ameyarya/peephole-door-cam/hardware/enclosure/stl/enclosure_lid.stl

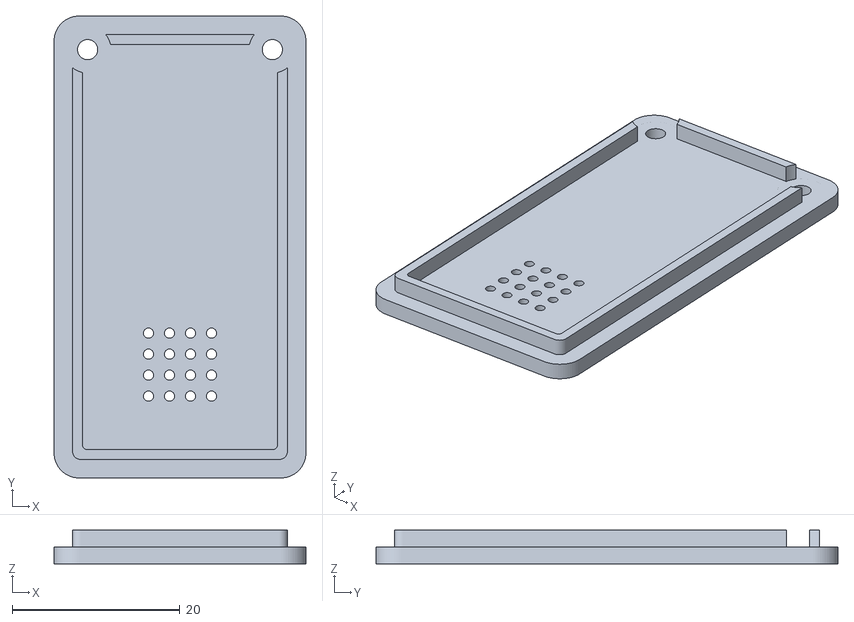
[picture p2: CAD file, 2026-10-30]
hardware/enclosure/stl/enclosure_lid.stl
30.0 x 55.0 x 3.99
