ameyarya/peephole-door-cam/hardware/peephole-mount/stl/housing_v2.stl

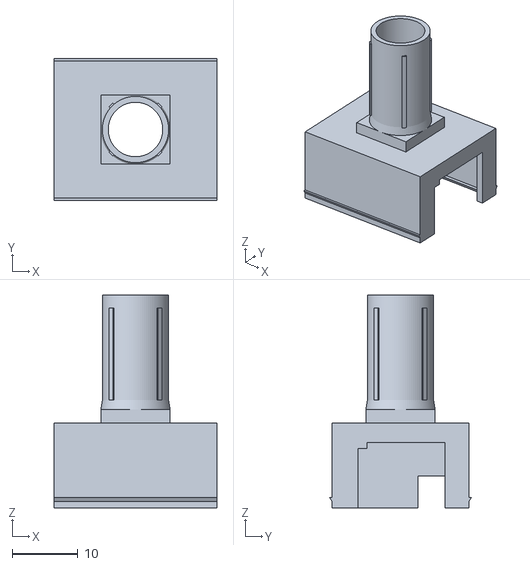
[picture p3: CAD file, 2026-11-03]
hardware/peephole-mount/stl/housing_v2.stl
24.8 x 21.7 x 32.5
