ameyarya/peephole-door-cam/hardware/peephole-sleeve/stl/sleeve_half.stl

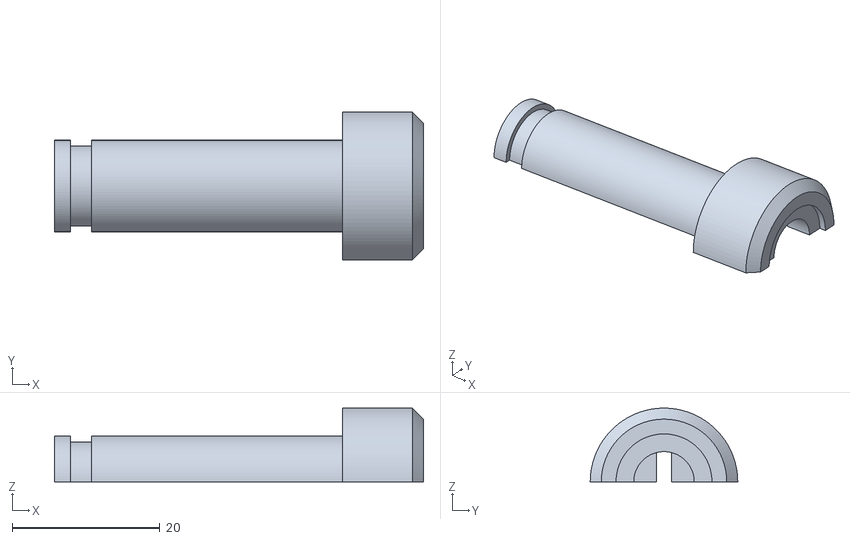
[picture p4: CAD file, 2026-10-30]
hardware/peephole-sleeve/stl/sleeve_half.stl
50.0 x 20.0 x 10.0
