ameyarya/peephole-door-cam/hardware/enclosure/stl/enclosure_body.stl

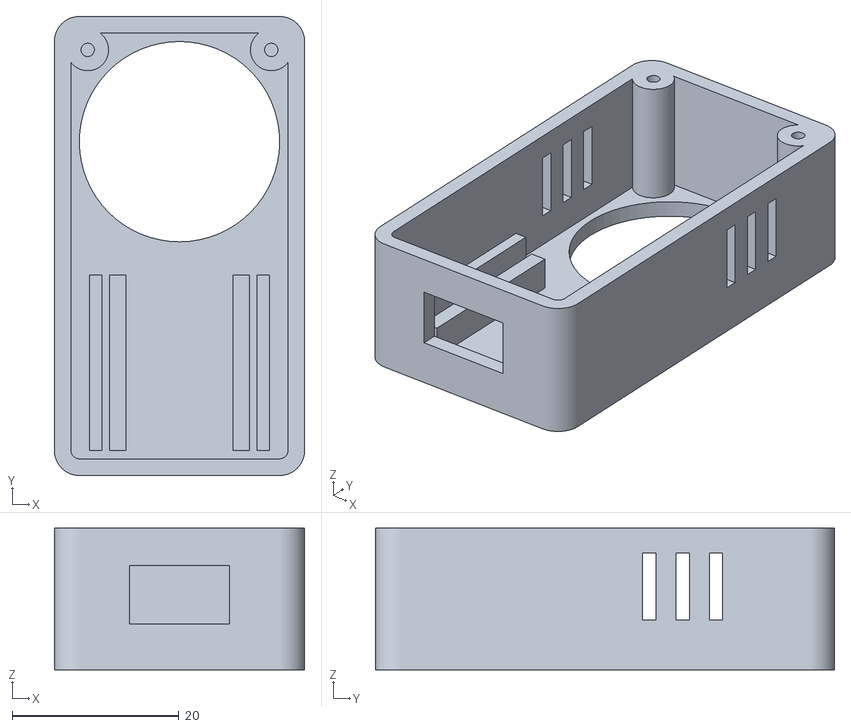
[picture p5: CAD file, 2026-10-30]
hardware/enclosure/stl/enclosure_body.stl
30.0 x 55.0 x 17.0
