ameyarya/peephole-door-cam/hardware/peephole-mount/stl/lid_v2.stl

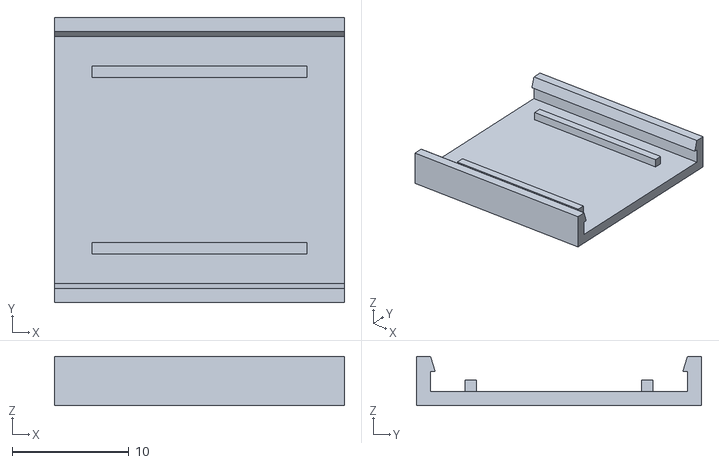
[picture p6: CAD file, 2026-11-03]
hardware/peephole-mount/stl/lid_v2.stl
24.8 x 24.4 x 4.20
