ameyarya/peephole-door-cam/hardware/peephole-sleeve/stl/clip.stl

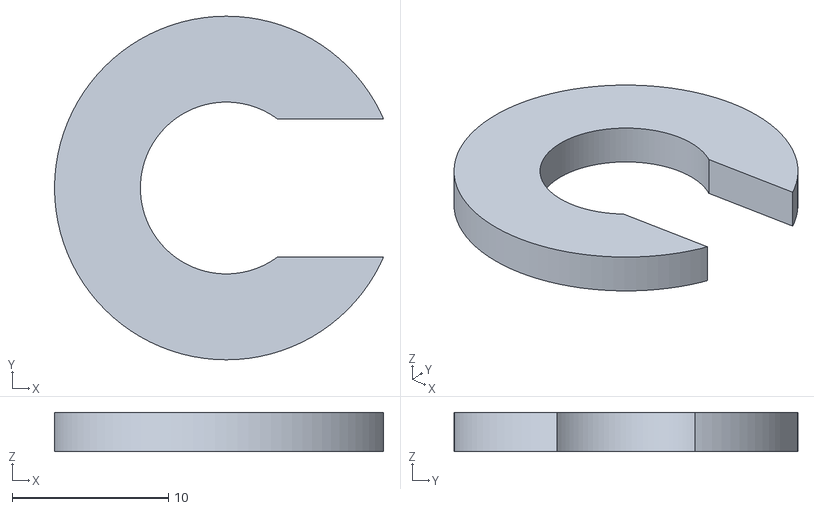
[picture p7: CAD file, 2026-10-30]
hardware/peephole-sleeve/stl/clip.stl
21.1 x 22.0 x 2.50
