ameyarya/peephole-door-cam/hardware/peephole-mount/stl/housing_v1.stl

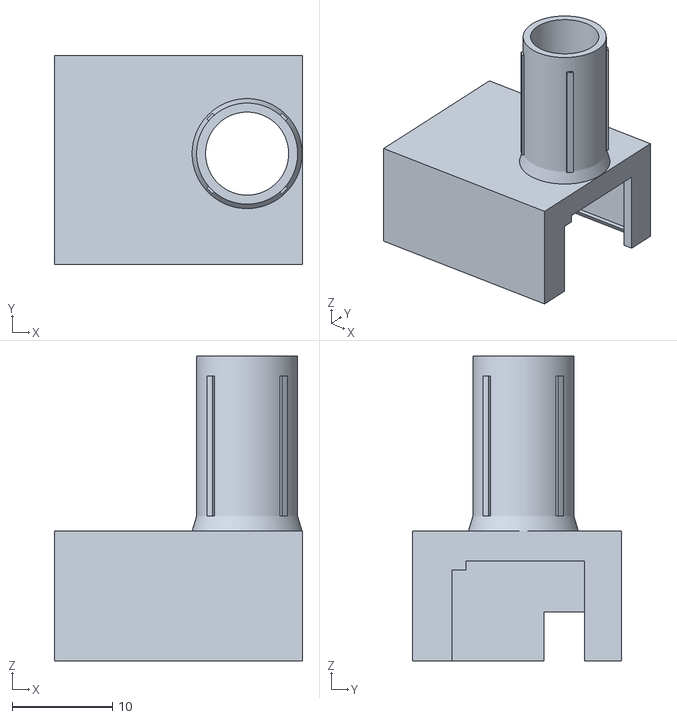
[picture p8: CAD file, 2026-11-03, an earlier design]
hardware/peephole-mount/stl/housing_v1.stl
24.8 x 20.9 x 30.5
