ameyarya/peephole-door-cam/firmware/src/main.cpp

// Door camera firmware for the XIAO ESP32S3 Sense and AI-Thinker ESP32-CAM.
//
//   http://door-cam.local/         test page
//   http://door-cam.local/capture  one JPEG
//   http://door-cam.local/status   JSON health info
//   http://door-cam.local/control?framesize=vga&quality=12&vflip=1&hmirror=0
//   http://door-cam.local:81/stream  MJPEG, up to 4 viewers at once
//   http://door-cam.local:82/audio?token=...  live 16 kHz mono PCM, up to 2 listeners
//   POST http://door-cam.local/ota  firmware image, with an X-Token header (see ota.sh)
//   POST http://door-cam.local/doorbell-url  body: the URL to POST to on a ring
//   POST http://door-cam.local/ring          acts as if the bell rang
//
// The camera and mic run all the time. With CHIME_DETECT the board listens for the
// doorbell itself, and only streams audio to someone holding the token.
//
// Only updates and the mic need the token in secrets.h. Everything else has no
// authentication, so keep this on a trusted network and never port-forward it.

#include <Arduino.h>
#include <ESPmDNS.h>
#include <HTTPClient.h>
#include <Preferences.h>
#include <WiFi.h>
#include <WiFiManager.h>

#include "esp_camera.h"
#include "esp_heap_caps.h"
#include "freertos/semphr.h"
#include "esp_http_server.h"

#if defined(AUDIO_STREAM) || defined(CHIME_DETECT)
#include "driver/i2s_pdm.h"
#endif

#ifdef BOARD_XIAO_S3_SENSE
#include <Update.h>
#include "esp_ota_ops.h"
#endif

#if __has_include("secrets.h")
#include "secrets.h"
#else
#define DOORCAM_TOKEN ""
#endif

static bool tokenMatches(const char *given) {
  return DOORCAM_TOKEN[0] != 0 && strcmp(given, DOORCAM_TOKEN) == 0;
}

static const char *HOSTNAME = "door-cam";
static const char *SETUP_AP = "door-cam-setup";

static camera_config_t cameraConfig() {
  camera_config_t c = {};
#ifdef BOARD_XIAO_S3_SENSE
  c.pin_pwdn = -1;
  c.pin_reset = -1;
  c.pin_xclk = 10;
  c.pin_sccb_sda = 40;
  c.pin_sccb_scl = 39;
  c.pin_d7 = 48;
  c.pin_d6 = 11;
  c.pin_d5 = 12;
  c.pin_d4 = 14;
  c.pin_d3 = 16;
  c.pin_d2 = 18;
  c.pin_d1 = 17;
  c.pin_d0 = 15;
  c.pin_vsync = 38;
  c.pin_href = 47;
  c.pin_pclk = 13;
#else  // AI-Thinker ESP32-CAM
  c.pin_pwdn = 32;
  c.pin_reset = -1;
  c.pin_xclk = 0;
  c.pin_sccb_sda = 26;
  c.pin_sccb_scl = 27;
  c.pin_d7 = 35;
  c.pin_d6 = 34;
  c.pin_d5 = 39;
  c.pin_d4 = 36;
  c.pin_d3 = 21;
  c.pin_d2 = 19;
  c.pin_d1 = 18;
  c.pin_d0 = 5;
  c.pin_vsync = 25;
  c.pin_href = 23;
  c.pin_pclk = 22;
#endif
  c.xclk_freq_hz = 10000000;  // half the usual 20 MHz: fewer frames from the sensor, and much less heat
  c.ledc_timer = LEDC_TIMER_0;
  c.ledc_channel = LEDC_CHANNEL_0;
  c.pixel_format = PIXFORMAT_JPEG;
  c.frame_size = FRAMESIZE_VGA;
  c.jpeg_quality = 12;
  c.fb_count = 2;
  c.fb_location = CAMERA_FB_IN_PSRAM;
  c.grab_mode = CAMERA_GRAB_LATEST;  // live view: drop stale frames
  return c;
}

static const int MAX_STREAM_CLIENTS = 4;
static const int MAX_CAPTURE_FAILURES = 5;
static const uint32_t FRAME_MS = 100;        // 10 frames a second is plenty for a door, and runs cooler
static const uint32_t CAMERA_IDLE_MS = 10000;  // the sensor sleeps this long after the last viewer leaves
static const int WAKE_SKIP_FRAMES = 4;       // frames to drop after waking, while exposure settles

static volatile uint32_t framesSent = 0;
static volatile int streamClients = 0;
static volatile uint32_t rings = 0;
static volatile bool updating = false;  // flash writes and camera DMA don't mix

#ifdef CHIME_DETECT
#include "chime_detector.h"
static ChimeDetector detector;
#endif

// One task grabs each camera frame and shares it with every viewer through
// reference-counted copies in PSRAM, so a slow or dead connection can't hold up
// the others.
struct SharedFrame {
  uint8_t *buf;
  size_t len;
  uint32_t seq;
  int refs;
};

static SemaphoreHandle_t frameLock;
static SharedFrame *latestFrame = nullptr;
static volatile int viewers = 0;
static volatile bool cameraAsleep = false;

static void releaseLocked(SharedFrame *frame) {
  if (frame && --frame->refs == 0) {
    heap_caps_free(frame->buf);
    heap_caps_free(frame);
  }
}

static void frameRelease(SharedFrame *frame) {
  xSemaphoreTake(frameLock, portMAX_DELAY);
  releaseLocked(frame);
  xSemaphoreGive(frameLock);
}

static uint32_t latestSeq() {
  xSemaphoreTake(frameLock, portMAX_DELAY);
  uint32_t seq = latestFrame ? latestFrame->seq : 0;
  xSemaphoreGive(frameLock);
  return seq;
}

// Waits for a frame newer than afterSeq. Returns nullptr on timeout.
static SharedFrame *frameAcquire(uint32_t afterSeq, TickType_t timeout) {
  TickType_t start = xTaskGetTickCount();
  for (;;) {
    xSemaphoreTake(frameLock, portMAX_DELAY);
    SharedFrame *frame = latestFrame;
    if (frame && frame->seq > afterSeq) {
      frame->refs++;
      xSemaphoreGive(frameLock);
      return frame;
    }
    xSemaphoreGive(frameLock);
    if (xTaskGetTickCount() - start >= timeout) return nullptr;
    vTaskDelay(pdMS_TO_TICKS(5));
  }
}

static void viewerAdd() {
  xSemaphoreTake(frameLock, portMAX_DELAY);
  viewers = viewers + 1;
  xSemaphoreGive(frameLock);
}

// Claims a stream slot. False when all are taken.
static bool streamSlotClaim() {
  xSemaphoreTake(frameLock, portMAX_DELAY);
  bool ok = streamClients < MAX_STREAM_CLIENTS;
  if (ok) streamClients = streamClients + 1;
  xSemaphoreGive(frameLock);
  return ok;
}

static void streamSlotRelease() {
  xSemaphoreTake(frameLock, portMAX_DELAY);
  streamClients = streamClients - 1;
  xSemaphoreGive(frameLock);
}

static void viewerRemove() {
  xSemaphoreTake(frameLock, portMAX_DELAY);
  viewers = viewers - 1;
  xSemaphoreGive(frameLock);
}

// The OV3660 has a software standby. The ESP32-CAM's OV2640 just keeps running.
static bool sensorSleep(bool sleep) {
  sensor_t *s = esp_camera_sensor_get();
  if (!s || s->id.PID != OV3660_PID) return false;
  s->set_reg(s, 0x3008, 0x40, sleep ? 0x40 : 0x00);  // SYSTEM CTROL0, bit 6: power down
  return true;
}

// Grabs frames only while someone is watching, at most one every FRAME_MS. With no
// viewers for CAMERA_IDLE_MS the sensor goes to standby, which keeps the board cool.
static void captureTask(void *) {
  uint32_t seq = 0;
  int failures = 0, skip = 0;
  uint32_t lastViewer = millis(), lastGrab = 0;
  for (;;) {
    if (viewers <= 0 || updating) {
      if (!cameraAsleep && viewers <= 0 && millis() - lastViewer > CAMERA_IDLE_MS && sensorSleep(true)) {
        cameraAsleep = true;
        Serial.println("No viewers: camera asleep");
      }
      vTaskDelay(pdMS_TO_TICKS(20));
      continue;
    }
    lastViewer = millis();
    if (cameraAsleep) {
      sensorSleep(false);
      cameraAsleep = false;
      skip = WAKE_SKIP_FRAMES;
      failures = 0;
    }
    uint32_t since = millis() - lastGrab;
    if (since < FRAME_MS) vTaskDelay(pdMS_TO_TICKS(FRAME_MS - since));
    lastGrab = millis();
    camera_fb_t *fb = esp_camera_fb_get();
    if (!fb) {
      if (++failures >= MAX_CAPTURE_FAILURES) {
        Serial.println("Camera keeps failing. Restarting.");
        ESP.restart();
      }
      vTaskDelay(pdMS_TO_TICKS(10));
      continue;
    }
    failures = 0;
    if (skip > 0) {  // stale or still settling after standby
      skip--;
      esp_camera_fb_return(fb);
      continue;
    }
    SharedFrame *frame = (SharedFrame *)heap_caps_malloc(sizeof(SharedFrame), MALLOC_CAP_SPIRAM);
    uint8_t *buf = (uint8_t *)heap_caps_malloc(fb->len, MALLOC_CAP_SPIRAM);
    if (!frame || !buf) {
      heap_caps_free(frame);
      heap_caps_free(buf);
      esp_camera_fb_return(fb);
      Serial.println("Out of PSRAM for a frame copy");
      vTaskDelay(pdMS_TO_TICKS(50));
      continue;
    }
    memcpy(buf, fb->buf, fb->len);
    *frame = {buf, fb->len, ++seq, 1};
    esp_camera_fb_return(fb);

    xSemaphoreTake(frameLock, portMAX_DELAY);
    SharedFrame *old = latestFrame;
    latestFrame = frame;
    releaseLocked(old);
    xSemaphoreGive(frameLock);
  }
}

static const char PAGE[] = R"html(<!doctype html>
<meta name=viewport content="width=device-width,initial-scale=1">
<title>Door cam</title>
<style>body{font:16px system-ui;margin:16px;background:#111;color:#eee}img{max-width:100%}a{color:#8cf}</style>
<h1>Door cam</h1>
<img id=s alt="live stream">
<p><a href=/capture>Snapshot</a> · <a href=/status>Status</a></p>
<script>s.src=location.protocol+'//'+location.hostname+':81/stream'</script>
)html";

static esp_err_t pageHandler(httpd_req_t *req) {
  httpd_resp_set_type(req, "text/html");
  return httpd_resp_send(req, PAGE, HTTPD_RESP_USE_STRLEN);
}

static esp_err_t captureHandler(httpd_req_t *req) {
  viewerAdd();
  SharedFrame *frame = frameAcquire(latestSeq(), pdMS_TO_TICKS(3000));
  viewerRemove();
  if (!frame) {
    httpd_resp_send_500(req);
    return ESP_FAIL;
  }
  httpd_resp_set_type(req, "image/jpeg");
  httpd_resp_set_hdr(req, "Cache-Control", "no-store");
  esp_err_t res = httpd_resp_send(req, (const char *)frame->buf, frame->len);
  frameRelease(frame);
  return res;
}

static const char *runningPartition() {
#ifdef BOARD_XIAO_S3_SENSE
  return esp_ota_get_running_partition()->label;
#else
  return "";
#endif
}

static esp_err_t statusHandler(httpd_req_t *req) {
  sensor_t *s = esp_camera_sensor_get();
  char json[640];
  snprintf(json, sizeof(json),
           "{\"ip\":\"%s\",\"rssi\":%d,\"uptime_s\":%lu,\"free_heap\":%u,"
           "\"free_psram\":%u,\"frames_sent\":%lu,\"stream_clients\":%d,\"rings\":%lu,"
           "\"framesize\":%d,\"quality\":%d,\"running\":\"%s\",\"built\":\"%s\","
           "\"camera_asleep\":%s,\"chip_c\":%.0f}",
           WiFi.localIP().toString().c_str(), WiFi.RSSI(),
           (unsigned long)(millis() / 1000), (unsigned)ESP.getFreeHeap(),
           (unsigned)ESP.getFreePsram(), (unsigned long)framesSent,
           streamClients, (unsigned long)rings, s ? s->status.framesize : -1,
           s ? s->status.quality : -1, runningPartition(), __DATE__ " " __TIME__,
           cameraAsleep ? "true" : "false", temperatureRead());
#ifdef CHIME_DETECT
  // Numbers about the last bell-like sound. No audio.
  ChimeDetector::Strike st;
  if (detector.lastStrike(&st)) {
    size_t used = strlen(json) - 1;
    snprintf(json + used, sizeof(json) - used,
             ",\"last_strike\":{\"age_s\":%.0f,\"level_db\":%.0f,\"purity\":%.2f,\"attack_db\":%.0f,"
             "\"fade_db_s\":%.1f,\"wobble_db\":%.2f,\"overtone_db\":%.0f,\"early_drop_db\":%.1f,\"passed\":%s}}",
             st.ageSeconds, st.level, st.purity, st.attack, st.fade, st.wobble, st.overtone, st.earlyDrop,
             st.passed ? "true" : "false");
  }
#endif
  httpd_resp_set_type(req, "application/json");
  return httpd_resp_send(req, json, HTTPD_RESP_USE_STRLEN);
}

static int frameSizeFromName(const char *name) {
  if (!strcmp(name, "qvga")) return FRAMESIZE_QVGA;
  if (!strcmp(name, "vga")) return FRAMESIZE_VGA;
  if (!strcmp(name, "svga")) return FRAMESIZE_SVGA;
  if (!strcmp(name, "xga")) return FRAMESIZE_XGA;
  if (!strcmp(name, "hd")) return FRAMESIZE_HD;
  return -1;
}

static esp_err_t controlHandler(httpd_req_t *req) {
  char query[96], value[16];
  sensor_t *s = esp_camera_sensor_get();
  if (!s || httpd_req_get_url_query_str(req, query, sizeof(query)) != ESP_OK) {
    httpd_resp_send_err(req, HTTPD_400_BAD_REQUEST, "missing settings");
    return ESP_FAIL;
  }
  if (httpd_query_key_value(query, "framesize", value, sizeof(value)) == ESP_OK) {
    int size = frameSizeFromName(value);
    if (size < 0) {
      httpd_resp_send_err(req, HTTPD_400_BAD_REQUEST, "unknown framesize");
      return ESP_FAIL;
    }
    s->set_framesize(s, (framesize_t)size);
  }
  if (httpd_query_key_value(query, "quality", value, sizeof(value)) == ESP_OK)
    s->set_quality(s, constrain(atoi(value), 4, 63));
  if (httpd_query_key_value(query, "vflip", value, sizeof(value)) == ESP_OK)
    s->set_vflip(s, atoi(value) ? 1 : 0);
  if (httpd_query_key_value(query, "hmirror", value, sizeof(value)) == ESP_OK)
    s->set_hmirror(s, atoi(value) ? 1 : 0);
  return httpd_resp_sendstr(req, "ok");
}

#define BOUNDARY "doorcamframe"

// Each viewer gets its own task, so several can watch at once.
static void streamClientTask(void *arg) {
  httpd_req_t *req = (httpd_req_t *)arg;
  httpd_resp_set_type(req, "multipart/x-mixed-replace;boundary=" BOUNDARY);
  httpd_resp_set_hdr(req, "Access-Control-Allow-Origin", "*");
  viewerAdd();

  char header[64];
  uint32_t lastSeq = latestSeq();
  esp_err_t res = ESP_OK;
  while (res == ESP_OK) {
    SharedFrame *frame = frameAcquire(lastSeq, pdMS_TO_TICKS(3000));
    if (!frame) {
      Serial.println("No camera frame for 3s, closing a viewer");
      break;
    }
    lastSeq = frame->seq;
    int n = snprintf(header, sizeof(header),
                     "\r\n--" BOUNDARY "\r\nContent-Type: image/jpeg\r\n"
                     "Content-Length: %u\r\n\r\n",
                     (unsigned)frame->len);
    res = httpd_resp_send_chunk(req, header, n);
    if (res == ESP_OK)
      res = httpd_resp_send_chunk(req, (const char *)frame->buf, frame->len);
    frameRelease(frame);
    if (res == ESP_OK) framesSent = framesSent + 1;
  }

  viewerRemove();
  streamSlotRelease();
  httpd_req_async_handler_complete(req);
  vTaskDelete(nullptr);
}

static esp_err_t streamHandler(httpd_req_t *req) {
  if (!streamSlotClaim()) {
    httpd_resp_set_status(req, "503 Service Unavailable");
    return httpd_resp_sendstr(req, "too many viewers\n");
  }
  httpd_req_t *asyncReq = nullptr;
  esp_err_t err = httpd_req_async_handler_begin(req, &asyncReq);
  if (err == ESP_OK && xTaskCreate(streamClientTask, "stream_client", 4096, asyncReq, 5, nullptr) != pdPASS) {
    httpd_req_async_handler_complete(asyncReq);
    err = ESP_ERR_NO_MEM;
  }
  if (err != ESP_OK) streamSlotRelease();
  return err;
}

static Preferences prefs;
static volatile bool ringPending = false;

static esp_err_t ringHandler(httpd_req_t *req) {
  ringPending = true;
  return httpd_resp_sendstr(req, "ok");
}

static esp_err_t doorbellUrlHandler(httpd_req_t *req) {
  char url[240];
  if (req->content_len >= sizeof(url)) {
    httpd_resp_send_err(req, HTTPD_400_BAD_REQUEST, "too long");
    return ESP_FAIL;
  }
  int got = httpd_req_recv(req, url, req->content_len);
  if (got < 0 || (size_t)got != req->content_len) {
    httpd_resp_send_err(req, HTTPD_400_BAD_REQUEST, "bad body");
    return ESP_FAIL;
  }
  url[got] = 0;
  prefs.putString("doorbell_url", url);
  return httpd_resp_sendstr(req, "ok");
}

// Runs outside the audio task, so a slow TV can't make it miss samples.
static void sendRing() {
  rings = rings + 1;
  String url = prefs.getString("doorbell_url", "");
  if (url.isEmpty()) {
    Serial.println("Ring, but no doorbell URL is set");
    return;
  }
  HTTPClient http;
  http.setConnectTimeout(3000);
  http.setTimeout(5000);
  if (!http.begin(url)) {
    Serial.println("Ring: bad doorbell URL");
    return;
  }
  Serial.printf("Ring sent, answer %d\n", http.POST(""));  // never logs the URL: it holds a secret
  http.end();
}

#if defined(AUDIO_STREAM) || defined(CHIME_DETECT)
static i2s_chan_handle_t micChannel = nullptr;

static bool startMic() {
  i2s_chan_config_t chan = I2S_CHANNEL_DEFAULT_CONFIG(I2S_NUM_0, I2S_ROLE_MASTER);
  if (i2s_new_channel(&chan, nullptr, &micChannel) != ESP_OK) return false;
  i2s_pdm_rx_config_t pdm = {};
  pdm.clk_cfg = I2S_PDM_RX_CLK_DEFAULT_CONFIG(16000);
  pdm.slot_cfg = I2S_PDM_RX_SLOT_DEFAULT_CONFIG(I2S_DATA_BIT_WIDTH_16BIT, I2S_SLOT_MODE_MONO);
  pdm.gpio_cfg.clk = GPIO_NUM_42;
  pdm.gpio_cfg.din = GPIO_NUM_41;
  return i2s_channel_init_pdm_rx_mode(micChannel, &pdm) == ESP_OK &&
         i2s_channel_enable(micChannel) == ESP_OK;
}

#endif

#ifdef AUDIO_STREAM
// The last second of audio, for listeners. One writer: micTask.
static const uint32_t AUDIO_RING = 16000;
static const int MAX_AUDIO_CLIENTS = 2;
static int16_t *audioRing = nullptr;
static volatile uint32_t audioWritten = 0;
static volatile int audioClients = 0;

static void audioClientTask(void *arg) {
  httpd_req_t *req = (httpd_req_t *)arg;
  httpd_resp_set_type(req, "audio/L16;rate=16000;channels=1");
  uint32_t at = audioWritten;
  esp_err_t res = ESP_OK;
  while (res == ESP_OK) {
    uint32_t written = audioWritten;
    if (written == at) {
      vTaskDelay(pdMS_TO_TICKS(10));
      continue;
    }
    if (written - at > AUDIO_RING) at = written - AUDIO_RING / 2;  // too slow: skip ahead
    uint32_t offset = at % AUDIO_RING;
    uint32_t count = min(written - at, AUDIO_RING - offset);
    res = httpd_resp_send_chunk(req, (const char *)(audioRing + offset), count * sizeof(int16_t));
    at += count;
  }
  xSemaphoreTake(frameLock, portMAX_DELAY);
  audioClients = audioClients - 1;
  xSemaphoreGive(frameLock);
  httpd_req_async_handler_complete(req);
  vTaskDelete(nullptr);
}

static esp_err_t audioHandler(httpd_req_t *req) {
  char query[96], token[64] = "";
  if (httpd_req_get_url_query_str(req, query, sizeof(query)) == ESP_OK)
    httpd_query_key_value(query, "token", token, sizeof(token));
  if (!tokenMatches(token) || !audioRing) {
    httpd_resp_set_status(req, "401 Unauthorized");
    return httpd_resp_sendstr(req, "token required\n");
  }
  xSemaphoreTake(frameLock, portMAX_DELAY);
  bool ok = audioClients < MAX_AUDIO_CLIENTS;
  if (ok) audioClients = audioClients + 1;
  xSemaphoreGive(frameLock);
  if (!ok) {
    httpd_resp_set_status(req, "503 Service Unavailable");
    return httpd_resp_sendstr(req, "too many listeners\n");
  }
  httpd_req_t *asyncReq = nullptr;
  esp_err_t err = httpd_req_async_handler_begin(req, &asyncReq);
  if (err == ESP_OK && xTaskCreate(audioClientTask, "audio_client", 4096, asyncReq, 4, nullptr) != pdPASS) {
    httpd_req_async_handler_complete(asyncReq);
    err = ESP_ERR_NO_MEM;
  }
  if (err != ESP_OK) {
    xSemaphoreTake(frameLock, portMAX_DELAY);
    audioClients = audioClients - 1;
    xSemaphoreGive(frameLock);
  }
  return err;
}
#endif

#if defined(AUDIO_STREAM) || defined(CHIME_DETECT)
// The one reader of the mic: hands samples to the doorbell detector and to listeners.
static void micTask(void *) {
  static int16_t samples[512];
  for (;;) {
    size_t bytes = 0;
    if (i2s_channel_read(micChannel, samples, sizeof(samples), &bytes, 1000) != ESP_OK) continue;
    size_t count = bytes / sizeof(int16_t);
#ifdef AUDIO_STREAM
    if (audioRing) {
      uint32_t written = audioWritten;
      for (size_t i = 0; i < count; i++) audioRing[(written + i) % AUDIO_RING] = samples[i];
      audioWritten = written + count;
    }
#endif
#ifdef CHIME_DETECT
    if (detector.feed(samples, count)) {
      Serial.println("Doorbell!");
      ringPending = true;
    }
#endif
  }
}
#endif

#ifdef BOARD_XIAO_S3_SENSE
// A new firmware stays on trial until setup() confirms the camera and WiFi work. If
// it restarts or crashes first, the bootloader goes back to the previous one.
extern "C" bool verifyRollbackLater() { return true; }

static esp_err_t otaHandler(httpd_req_t *req) {
  char token[64] = "";
  httpd_req_get_hdr_value_str(req, "X-Token", token, sizeof(token));
  if (!tokenMatches(token)) {
    httpd_resp_set_status(req, "401 Unauthorized");
    return httpd_resp_sendstr(req, "token required\n");
  }
  updating = true;
  bool ok = Update.begin(req->content_len, U_FLASH);
  static char chunk[2048];
  size_t left = req->content_len;
  while (ok && left > 0) {
    int got = httpd_req_recv(req, chunk, min(left, sizeof(chunk)));
    if (got == HTTPD_SOCK_ERR_TIMEOUT) continue;
    ok = got > 0 && Update.write((uint8_t *)chunk, got) == (size_t)got;
    if (ok) left -= got;
  }
  ok = ok && Update.end(true);
  if (!ok) {
    Update.abort();
    updating = false;
    httpd_resp_set_status(req, "500 Internal Server Error");
    return httpd_resp_sendstr(req, "update failed\n");
  }
  httpd_resp_sendstr(req, "ok, restarting\n");
  delay(500);
  ESP.restart();
  return ESP_OK;
}
#endif

static void addRoute(httpd_handle_t server, const char *uri,
                     esp_err_t (*handler)(httpd_req_t *)) {
  httpd_uri_t route = {};
  route.uri = uri;
  route.method = HTTP_GET;
  route.handler = handler;
  httpd_register_uri_handler(server, &route);
}

// Streams run on their own server so they can't get in the way of the control pages.
static bool startServers() {
  httpd_config_t config = HTTPD_DEFAULT_CONFIG();
  httpd_handle_t web = nullptr, stream = nullptr;

  config.server_port = 80;
  config.ctrl_port = 32768;
  if (httpd_start(&web, &config) != ESP_OK) return false;
  addRoute(web, "/", pageHandler);
  addRoute(web, "/capture", captureHandler);
  addRoute(web, "/status", statusHandler);
  addRoute(web, "/control", controlHandler);
  httpd_uri_t ring = {};
  ring.uri = "/ring";
  ring.method = HTTP_POST;
  ring.handler = ringHandler;
  httpd_register_uri_handler(web, &ring);
  httpd_uri_t doorbellUrl = {};
  doorbellUrl.uri = "/doorbell-url";
  doorbellUrl.method = HTTP_POST;
  doorbellUrl.handler = doorbellUrlHandler;
  httpd_register_uri_handler(web, &doorbellUrl);
#ifdef BOARD_XIAO_S3_SENSE
  httpd_uri_t ota = {};
  ota.uri = "/ota";
  ota.method = HTTP_POST;
  ota.handler = otaHandler;
  httpd_register_uri_handler(web, &ota);
#endif

  config.server_port = 81;
  config.ctrl_port = 32769;
  config.max_open_sockets = MAX_STREAM_CLIENTS + 1;
  config.send_wait_timeout = 2;  // free a dead viewer's slot quickly
  if (httpd_start(&stream, &config) != ESP_OK) return false;
  addRoute(stream, "/stream", streamHandler);

#ifdef AUDIO_STREAM
  httpd_handle_t audio = nullptr;
  config.server_port = 82;
  config.ctrl_port = 32770;
  config.max_open_sockets = MAX_AUDIO_CLIENTS + 1;
  if (httpd_start(&audio, &config) != ESP_OK) return false;
  addRoute(audio, "/audio", audioHandler);
#endif
  return true;
}

void setup() {
  setCpuFrequencyMhz(160);  // down from 240: enough for the stream and the chime detector, and cooler
  Serial.begin(115200);
  Serial.println("\nDoor cam starting");
#ifdef ROLLBACK_TEST  // a deliberately bad firmware, for testing that rollback works
  delay(3000);
  ESP.restart();
#endif

  if (!psramFound()) Serial.println("Warning: no PSRAM found");
  camera_config_t config = cameraConfig();
  esp_err_t err = esp_camera_init(&config);
  if (err != ESP_OK) {
    Serial.printf("Camera init failed: 0x%x. Check the ribbon cable. Restarting.\n", err);
    delay(5000);
    ESP.restart();
  }
  frameLock = xSemaphoreCreateMutex();
  xTaskCreatePinnedToCore(captureTask, "capture", 4096, nullptr, 6, nullptr, 1);
#ifdef BOARD_XIAO_S3_SENSE
  // The OV3660 is mirrored natively.
  esp_camera_sensor_get()->set_hmirror(esp_camera_sensor_get(), 1);
#endif
#if defined(AUDIO_STREAM) || defined(CHIME_DETECT)
  if (!startMic()) Serial.println("Warning: mic failed to start");
#ifdef AUDIO_STREAM
  audioRing = (int16_t *)heap_caps_malloc(AUDIO_RING * sizeof(int16_t), MALLOC_CAP_SPIRAM);
#endif
#endif
  prefs.begin("doorcam");

  WiFi.mode(WIFI_STA);
  WiFi.setHostname(HOSTNAME);
  // No radio power save: it makes the stream stutter, and with the camera asleep it drops the
  // board's draw so low that many power banks switch themselves off.
  WiFi.setSleep(false);

  // Credentials live in the board's flash, set from a phone on first boot.
  WiFiManager manager;
  manager.setConfigPortalTimeout(300);
  if (!manager.autoConnect(SETUP_AP)) {
    Serial.println("WiFi setup timed out. Restarting.");
    ESP.restart();
  }

  WiFi.setTxPower(WIFI_POWER_11dBm);  // a quarter of full power; plenty indoors, and less heat
  if (MDNS.begin(HOSTNAME)) MDNS.addService("http", "tcp", 80);
  if (!startServers()) {
    Serial.println("Could not start web servers. Restarting.");
    ESP.restart();
  }
#if defined(AUDIO_STREAM) || defined(CHIME_DETECT)
  if (micChannel) xTaskCreatePinnedToCore(micTask, "mic", 6144, nullptr, 3, nullptr, 0);
#endif
#ifdef BOARD_XIAO_S3_SENSE
  esp_ota_mark_app_valid_cancel_rollback();  // camera and WiFi came up: keep this firmware
#endif
  Serial.printf("Ready: http://%s/ or http://%s.local/\n",
                WiFi.localIP().toString().c_str(), HOSTNAME);
}

void loop() {
  if (ringPending) {
    ringPending = false;
    if (WiFi.status() == WL_CONNECTED) sendRing();
  }
  static uint32_t lostSince = 0;
  if (WiFi.status() == WL_CONNECTED) {
    lostSince = 0;
  } else if (lostSince == 0) {
    lostSince = millis();
  } else if (millis() - lostSince > 60000) {
    Serial.println("WiFi lost for 60s. Restarting.");
    ESP.restart();
  }
  delay(100);
}
