ameyarya/peephole-door-cam/firmware/src/chime_model.h

// Your doorbell, from tools/chime_data/chime_model.json. Regenerate with:
//   uv run tools/chime.py header
#pragma once

#define CHIME_TONE_HZ 765.6
#define CHIME_TONE_WIDTH_HZ 40.0
#define CHIME_MIN_LEVEL 0.03918430528433086
#define CHIME_MIN_ATTACK_DB 10.0
#define CHIME_FADE_MIN_DB_S -70.0
#define CHIME_FADE_MAX_DB_S -14.13
#define CHIME_MAX_WOBBLE_DB 5.0
#define CHIME_MAX_OVERTONE_DB -15.0
#define CHIME_MIN_EARLY_DROP_DB 2.0
#define CHIME_THRESHOLD 0.4964
#define CHIME_COOLDOWN_S 5
