ameyarya/peephole-door-cam/(commit log)

2026-10-30 Add peephole camera sleeve and XIAO enclosure models
    Parametric OpenSCAD models with rendered STLs for a renter-friendly
    peephole door camera: clamshell sleeve + clip that replace the door
    viewer, and an inside enclosure for the XIAO ESP32S3 Sense.
    [clip.stl, enclosure.scad, enclosure_body.stl, enclosure_lid.stl, peephole_sleeve.scad, sleeve_half.stl]
2026-11-02 Add door camera firmware, motion recorder and chime trainer
    Firmware for the XIAO ESP32S3 Sense and AI-Thinker ESP32-CAM: MJPEG stream
    for up to 4 viewers, snapshots, status and camera settings. WiFi is set up
    from a phone, so no credentials live in the repo. The xiao_sense_training
    build adds a mic audio stream for doorbell training.
    tools/recorder.py saves motion clips from the stream. tools/chime.py
    records, trains and tests a tone-based detector on your own doorbell, using
    either the board's mic or the computer's.
    [partitions_xiao.csv]
2026-11-02 Train single-note chime detector from one recording
    tools/chime_sim.py simulates one doorbell recording across rooms, volumes,
    mics and background noise, then evaluates on held-out simulations, including
    a long-run false alarm rate. Single-note bells are matched on pitch, sudden
    strike, steady fade and lack of overtones.
    Unproven on a real mic: no detections so far in playback tests through the
    XIAO, and the cause isn't known. The docs say so.
2026-11-02 Detect the doorbell on the board and ring the TV
    xiao_sense now listens for the bell itself, with no audio leaving the board, and
    POSTs to a URL stored on the board. The detector ports tools/chime.py's checks and
    a test compares the two. /status reports the last bell-like sound as numbers.
    Loosened after real rings were rejected: bells right after other noise had too
    small a jump, and one ring faded faster than the recording. A new early-drop check
    keeps steady beeps out. Training now refuses a model that can't separate the bell
    from background.
    [chime_detector.h, chime_model.h, main.cpp]
2026-11-02 Add WiFi updates and keep the camera and mic always live
    POST /ota with ./ota.sh updates the XIAO, with automatic rollback if the new
    firmware doesn't bring up the camera and WiFi. Both tested on a board. The mic
    stream and updates need a token in the git-ignored src/secrets.h. The training
    build is gone: xiao_sense now does everything.
    [main.cpp]
2026-11-03 Sentry recording: 10 seconds around motion, served to the Smart Home page
    The recorder keeps 10 seconds before and after motion, and serves clips over a
    private link with its live state, so the page can show and delete them. Adds the
    sliding peephole mount, which films through the existing viewer. Its sizes come
    from measurements and a photo and aren't fit-tested yet.
    [fit_test.stl, mount.stl, peephole_mount.scad]
2026-11-03 Docs: recordings open from the door camera's popup
2026-11-03 Peephole mount: camera size from Seeed's 3D model (8.0 mm square, not 10.4)
    [fit_test.stl, mount.stl, peephole_mount.scad]
2026-11-03 Door unit: a housing for the whole XIAO Sense, hanging from the viewer tube
    [fit_test.stl, housing.stl, mount.stl, peephole_mount.scad]
2026-11-03 Door unit: crush ribs on the tube instead of a fit test, thinner walls, more board clearance
    [fit_test.stl, housing.stl, peephole_mount.scad]
2026-11-03 Door unit v2: square socket for the camera, snap-on back lid; first print kept as housing_v1
    [housing_v1.stl, housing_v2.stl, lid_v2.stl, peephole_mount.scad]
2026-11-03 Door unit v2: tube in the middle of the housing, camera follows on its flex
    [housing_v2.stl, peephole_mount.scad]
2026-11-03 Firmware: camera sleeps with no viewers, half camera clock, 10 fps, radio power save, 160 MHz; chip temperature in /status
2026-11-03 Docs: temperature note
2026-11-03 Firmware: keep the radio awake when idle, so power banks don't switch the board off
